AW14Saurabh/cubesat-adcs/Reaction Wheel Platform/RWS v3/PCBs/readme.txt

Readme

PowerV2 - Batteries, VReg + Current sensing PCB (holes spaced to 10xAA battery holder cut in half)
ADCSHubV2 - OBC, Comms, sensors for ADCS
RWSv3a - electronics for Reaction Wheel System
