AW14Saurabh/cubesat-adcs/Reaction Wheel Platform/RWS v3/Code/V2/readme.txt

Don't forget to put everything in the Libraries folder into your arduino libraries folder :)
