AW14Saurabh/cubesat-adcs/Reaction Wheel Platform/RWS v3/PCBs/ADCSHubV2/[BLUESAT FONT].png

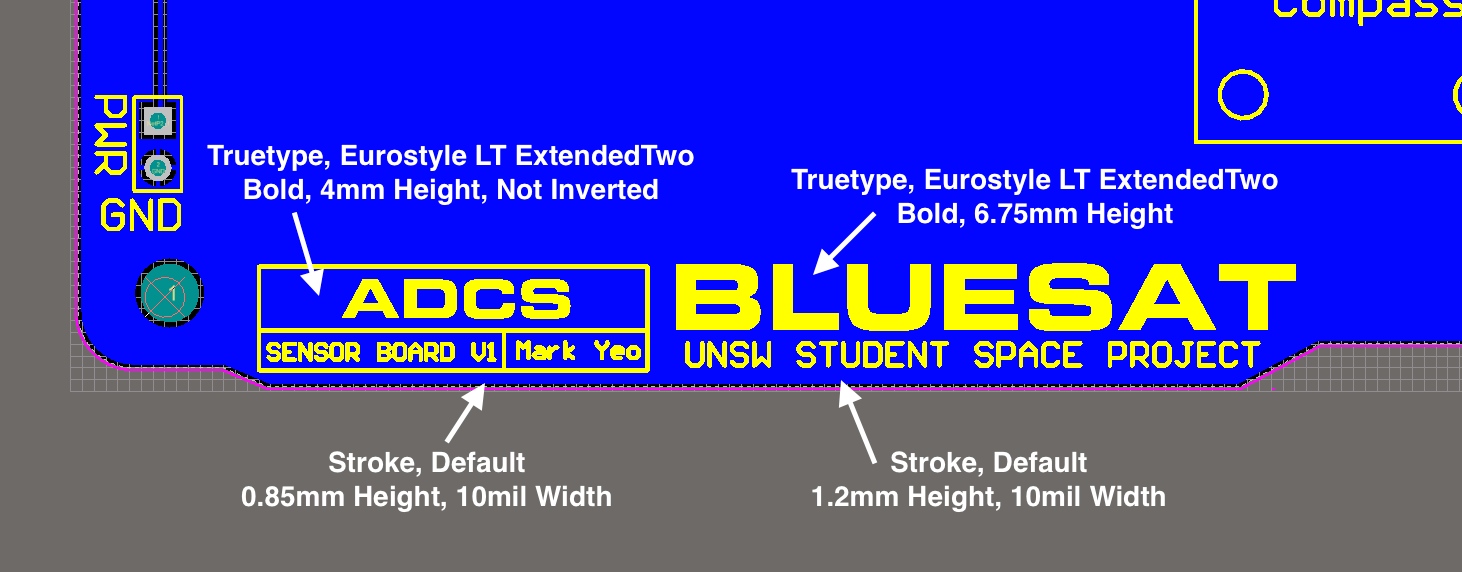
Reaction Wheel Platform/RWS v3/PCBs/ADCSHubV2/[BLUESAT FONT].png
