AW14Saurabh/cubesat-adcs/Reaction Wheel Platform/RWS v3/PCBs/ADCSHubV2/Project Outputs for ADCSHubV2/ADCSHubV2.CSV

Bill of Material for
On 2018-05-08 at 4:01:31 PM
Comment | Pattern | Quantity | Components
10uF | 0805C-GENERIC | 2 | C3, C5 | CAPACITOR 0805 CERAMIC
10uF | 0805C-TBD | 2 | C1, C2 | CAPACITOR 0805 CERAMIC
150R | 0805R-150 | 3 | R4, R5, R6 | RESISTOR 0805 1/4 WATT THIN FILM
200K | 0805R-4K7 | 1 | R11 | RESISTOR 0805 1/4 WATT THIN FILM
26X2 Header | 26X2 Header | 2 | H1, H2
4K7 | 0805R-4K7 | 10 | R1, R2, R3, R7, R8, R9, R10, R12, R13, R14 | RESISTOR 0805 1/4 WATT THIN FILM
Arduino Pro Mini | Arduino Pro Mini | 2 | H4, H5 | Arduino Pro Mini
DPDT Switch | DPDT SWITCH | 1 | SW1 | DPDT Switch
Header 6 | HDR1X6 | 2 | H3, H12 | Header, 6-Pin
HEADER-1X2 | HEADER-1X2 | 2 | H10, H11
HMC5883L | HMC5883L | 1 | H6 | Magnetometer
L3GD20H | L3GD20H | 1 | H7 | Gyroscope
LED | LED | 3 | D1, D2, D3 | Small LED
NRF24L01 | NRF24L01 | 1 | H9 | Radio Transceiver
PCA9306 | PCA9306 (DCT) | 1 | U2 | Dual Bidirectional I2C Voltage Level Translator
PushButton | PushButton | 1 | PB1
uSD Card Module | uSD Card Module | 1 | H8 | uSD Card Module
