AW14Saurabh/cubesat-adcs/Reaction Wheel Platform/RWS v3/Mech Parts/PCB.step

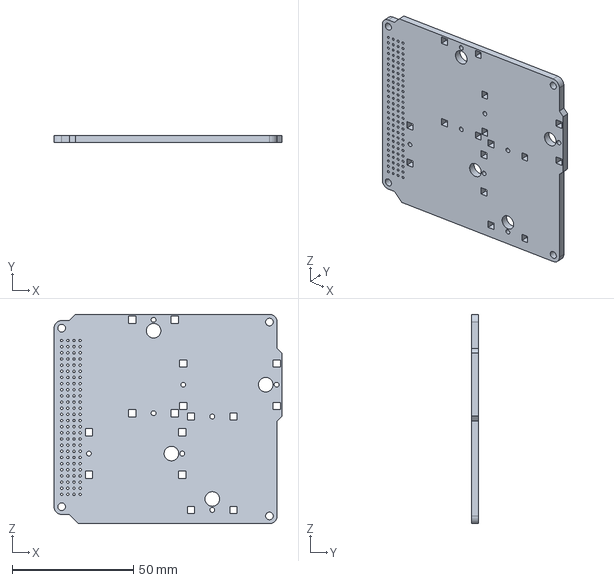
[picture p3: CAD file, 2018-05-28]
Reaction Wheel Platform/RWS v3/Mech Parts/PCB.step
94.1 x 3.00 x 86.4 mm
