AW14Saurabh/cubesat-adcs/Reaction Wheel Platform/RWS v3/Mech Parts/TopPlate.step

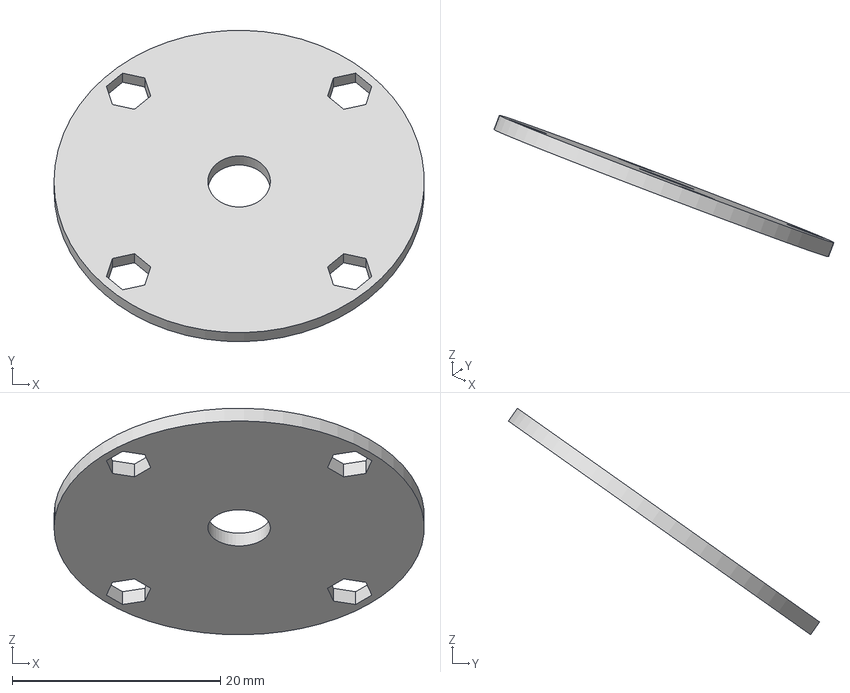
[picture p4: CAD file, 2018-05-28]
Reaction Wheel Platform/RWS v3/Mech Parts/TopPlate.step
35.5 x 29.9 x 21.7 mm
