AW14Saurabh/cubesat-adcs/Reaction Wheel Platform/RWS v3/Mech Parts/SidePlateL.step

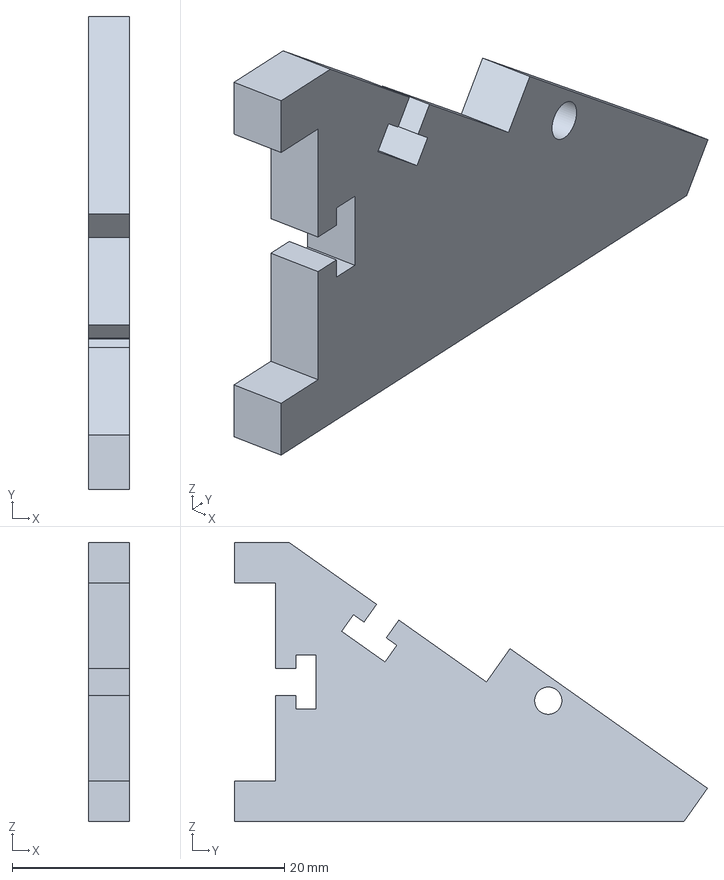
[picture p5: CAD file, 2018-05-28]
Reaction Wheel Platform/RWS v3/Mech Parts/SidePlateL.step
3.00 x 34.7 x 20.5 mm
