AW14Saurabh/cubesat-adcs/Reaction Wheel Platform/RWS v3/Mech Parts/BackPlate.step

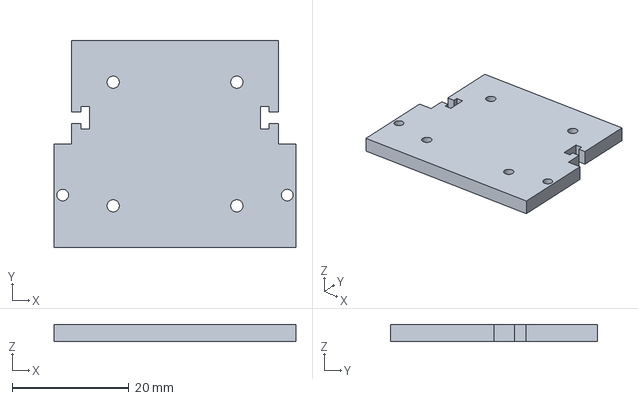
[picture p6: CAD file, 2018-05-28]
Reaction Wheel Platform/RWS v3/Mech Parts/BackPlate.step
41.5 x 35.5 x 3.00 mm
