AW14Saurabh/cubesat-adcs/Reaction Wheel Platform/RWS v3/Data Analysis/Support/Current Calibration.xlsx

Current (A) | Arduino reading
0.62 | 383.9675926 | 369 | 289 | 235 | 233 | 143
0.93 | 302.3868613 | 350 | 299 | 253 | 227 | 173
1.06 | 264.4245283 | 368 | 278 | 268 | 180 | 133
1.26 | 216.5129534 | 419 | 317 | 284 | 212 | 165
1.49 | 150.1578947 | 383 | 327 | 283 | 199 | 145
 |  | 377 | 304 | 267 | 245 | 130
 |  | 380 | 307 | 230 | 206 | 166
 |  | 369 | 312 | 249 | 205 | 133
 | Ard = -267.31*I+550.05 | 401 | 272 | 255 | 192 | 183
I = -Ard/267.31+2.0577 |  | 358 | 315 | 268 | 185 | 158
 |  | 374 | 302 | 306 | 246 | 147
 |  | 371 | 290 | 250 | 214 | 162
 |  | 384 | 309 | 308 | 237 | 150
 |  | 426 | 330 | 283 | 221 | 165
 |  | 388 | 323 | 250 | 242 | 163
 |  | 443 | 282 | 266 | 234 | 143
 |  | 367 | 315 | 252 | 237 | 173
 |  | 388 | 309 | 239 | 204 | 184
 |  | 357 | 275 | 266 | 227 | 136
 |  | 331 | 340 | 299 | 222 | 130
 |  | 388 | 339 | 260 | 205 | 176
 |  | 358 | 316 | 259 | 229 | 139
 |  | 394 | 301 | 281 | 191 | 157
 |  | 402 | 280 | 257 | 207 | 163
 |  | 397 | 312 | 262 | 200 | 158
 |  | 374 | 324 | 259 | 214 | 143
 |  | 389 | 279 | 285 | 236 | 147
 |  | 359 | 288 | 253 | 196 | 131
 |  | 354 | 381 | 313 | 228 | 160
 |  | 416 | 283 | 279 | 226 | 143
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
