AW14Saurabh/cubesat-adcs/Reaction Wheel Platform/RWS v3/Code/V1/RWS/Motor Driver Testing/MotorFreqData/MotorFreqCalib.xlsx

Sheet: FreqChip
T | Freq | Vout |  |  |  |  |  | Vout Ave |  | Datasheet values
1 | 1000 | 738 | 738 | 742 | 742 | 747 | 747 | 742.3333333 |  | 760 | 5 | 100000 | 1e-08 | 3.8 | 777.48
1 | 1000 | 368 | 367 | 371 | 369 | 374 | 372 | 370.1666667 |  | 700 | 5 | 100000 | 1e-08 | 3.5 | 716.1
2 | 500 | 188 | 187 | 189 | 188 | 191 | 190 | 188.8333333 |  | 650 | 5 | 100000 | 1e-08 | 3.25 | 664.95
3 | 333.3333333 | 125 | 124 | 125 | 125 | 126 | 126 | 125.1666667 |  | 600 | 5 | 100000 | 1e-08 | 3 | 613.8
4 | 250 | 93 | 93 | 93 | 93 | 94 | 94 | 93.33333333 |  | 550 | 5 | 100000 | 1e-08 | 2.75 | 562.65
5 | 200 | 76 | 76 | 76 | 76 | 77 | 77 | 76.33333333 |  | 500 | 5 | 100000 | 1e-08 | 2.5 | 511.5
7 | 142.8571429 | 63 | 63 | 63 | 63 | 63 | 63 | 63 |  | 450 | 5 | 100000 | 1e-08 | 2.25 | 460.35
7 | 142.8571429 | 52 | 52 | 52 | 52 | 52 | 52 | 52 |  | 400 | 5 | 100000 | 1e-08 | 2 | 409.2
508 | 1968.503937 | 749 | 749 |  |  |  |  | 749
780 | 1282.051282 | 496 | 493 |  |  |  |  | 493
1004 | 996.0159363 | 377 | 375 |  |  |  |  | 375
1280 | 781.25 | 300 | 298 |  |  |  |  | 298
1504 | 664.893617 | 254 | 253 |  |  |  |  | 253
1788 | 559.2841163 | 219 | 217 |  |  |  |  | 217
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
