AW14Saurabh/cubesat-adcs/Reaction Wheel Platform/RWS v3/Code/V1/RWS/Motor Driver Testing/MotorFreqData/expected vout from freq.xlsx

 | Freq | VCC | R1 | C1 | Vout
Max | 760 | 5 | 100000 | 1e-08 | 3.8
Min reliable | 60 | 5 | 100000 | 1e-08 | 0.3
 |  | VOUT = fIN × VCC × R1 × C1
