AW14Saurabh/cubesat-adcs/Reaction Wheel Platform/RWS v3/Mech Parts/Engineering Drawings/MountingPlate.pdf

# 2.54 ².54

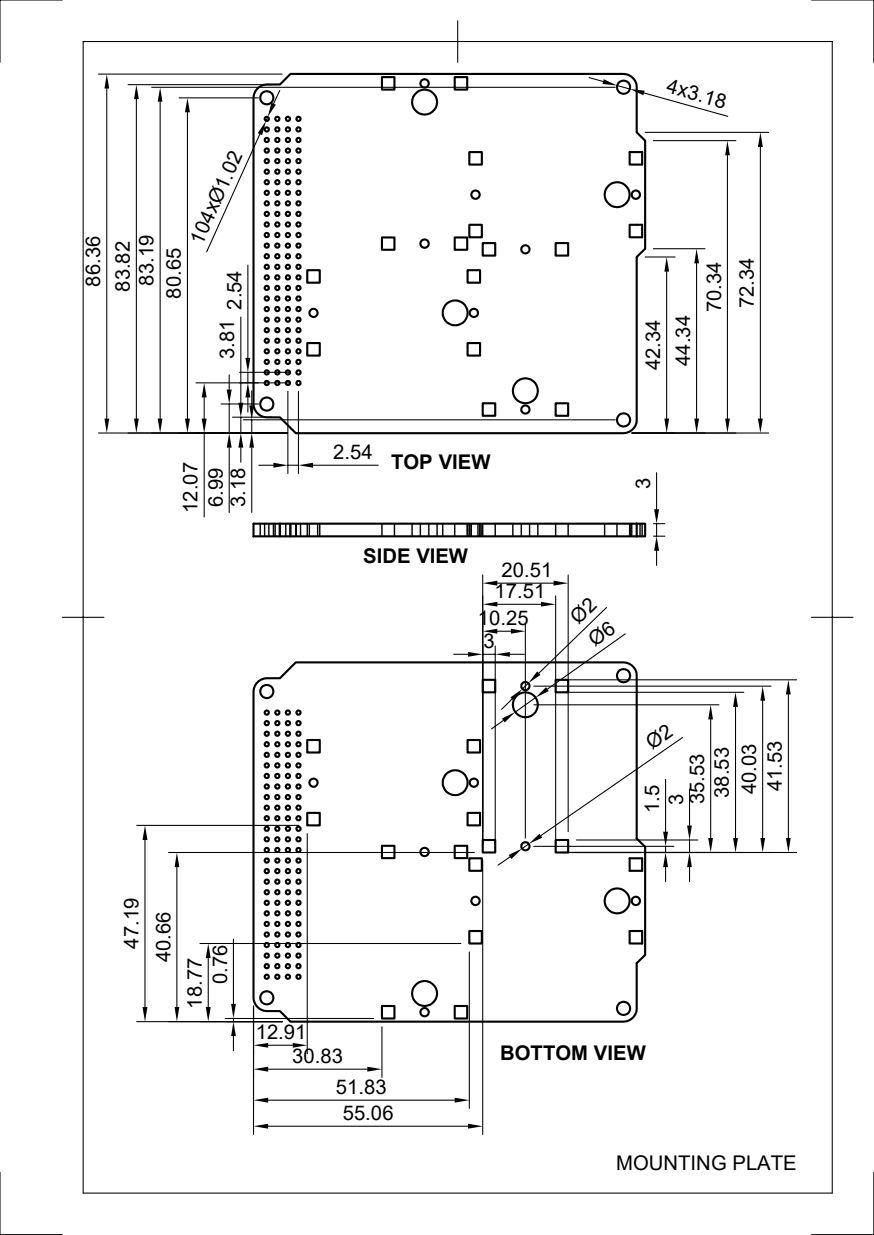
[picture p8: page 1]
TOP VIEW; SIDE VIEW; BOTTOM VIEW; MOUNTING PLATE
