AW14Saurabh/cubesat-adcs/Reaction Wheel Platform/RWS v3/Mech Parts/Engineering Drawings/Wheel.pdf

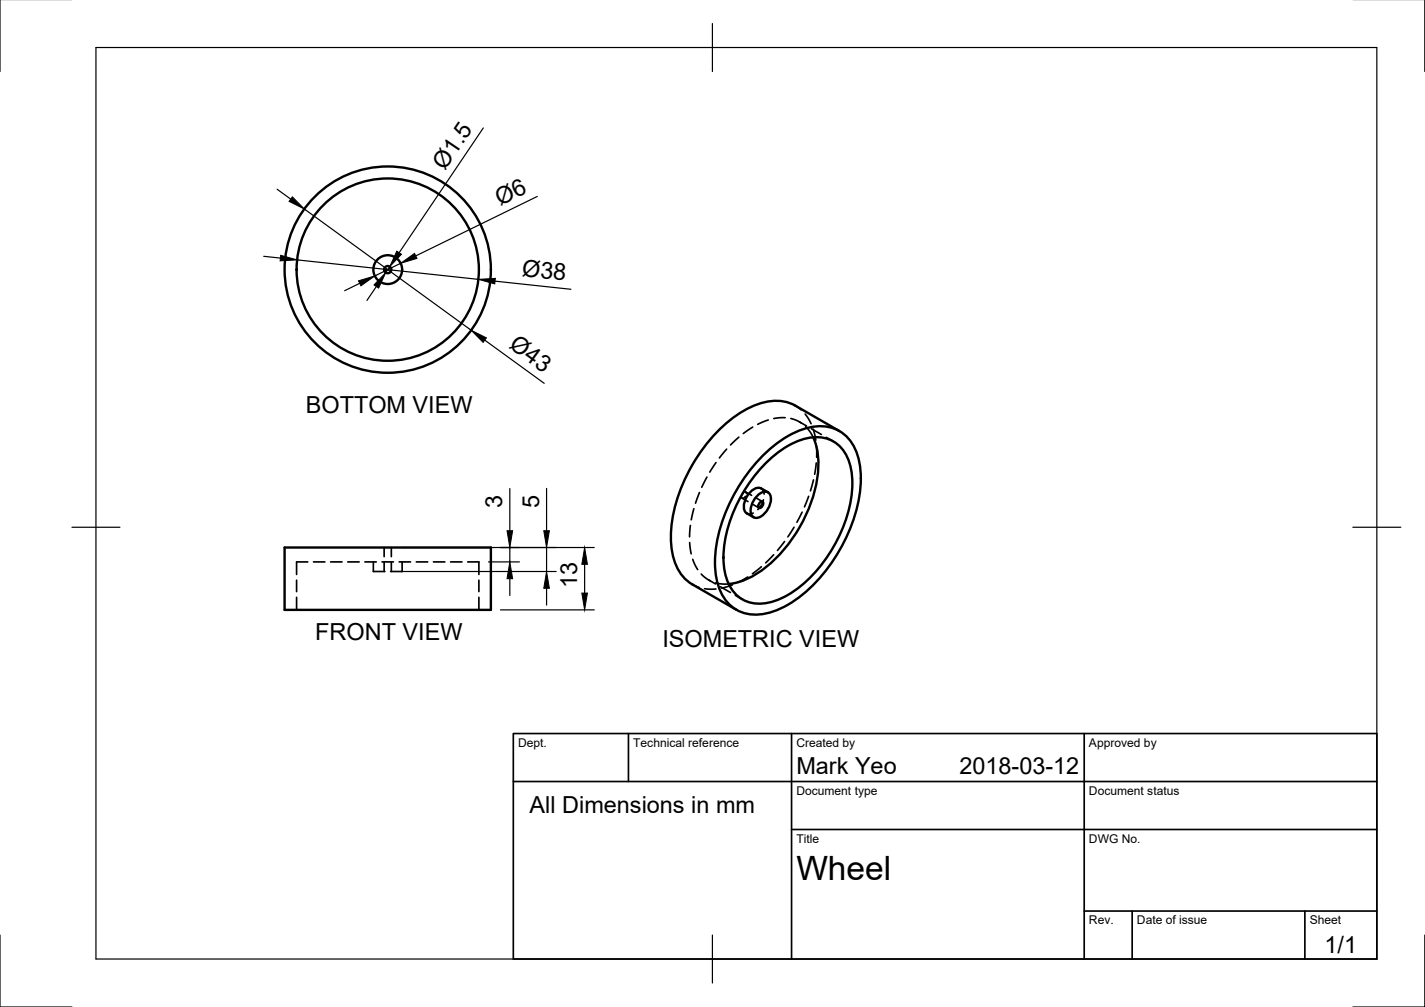
[picture p9: page 1]
BOTTOM VIEW; FRONT VIEW; ISOMETRIC VIEW

Dept. | Technical reference | Created by Mark Yeo 2018-03-12 | Approved by

All Dimensions in mm | | Document type | Document status

Title Wheel | DWG No.

Rev. | Date of issue | Sheet 1/1
