AW14Saurabh/cubesat-adcs/Reaction Wheel Platform/RWS v3/Mech Parts/Engineering Drawings/CutRing.pdf

# TOP VIEW

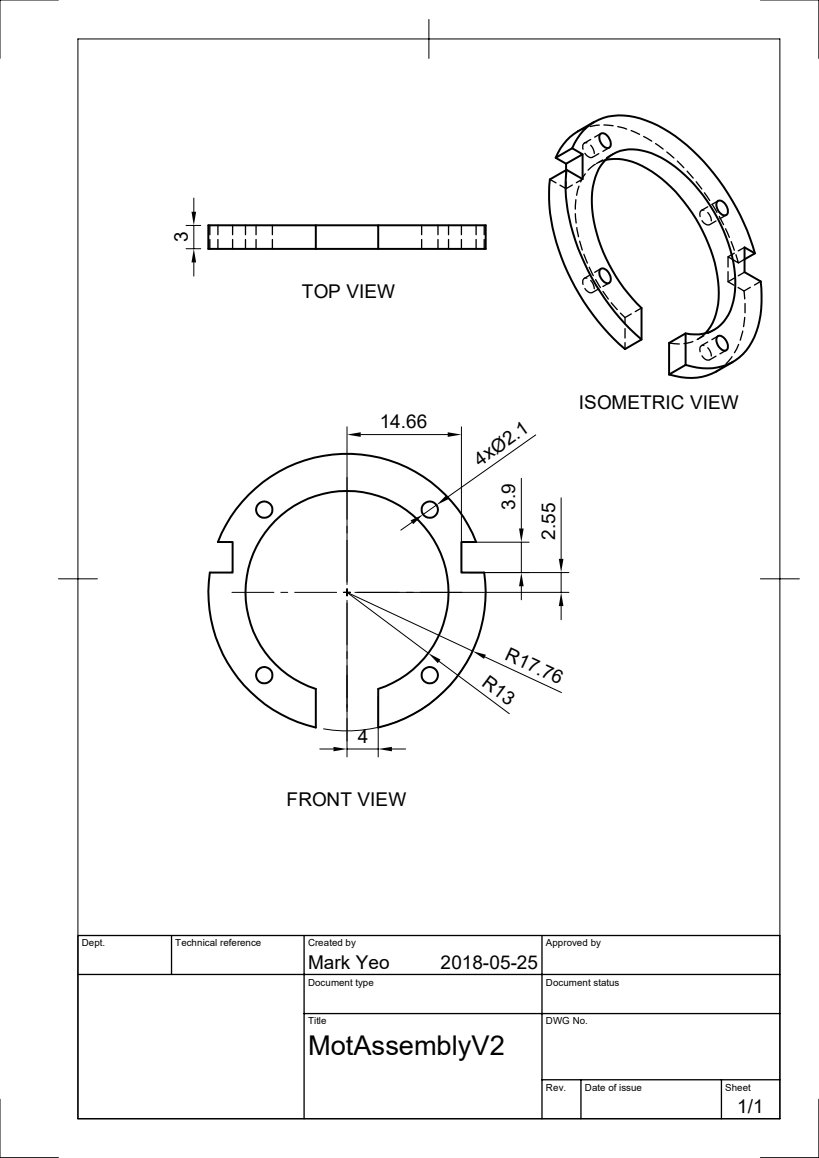
[picture p11: page 1]
Dept.; Technical reference; Created by; Approved by; Mark Yeo; FRONT VIEW; ISOMETRIC VIEW

Document type | Document status

Title MotAssemblyV2 | DWG No.

Rev. | Date of issue | Sheet 1/1
