AW14Saurabh/cubesat-adcs/Reaction Wheel Platform/RWS v3/Mech Parts/Engineering Drawings/TopPlate.pdf

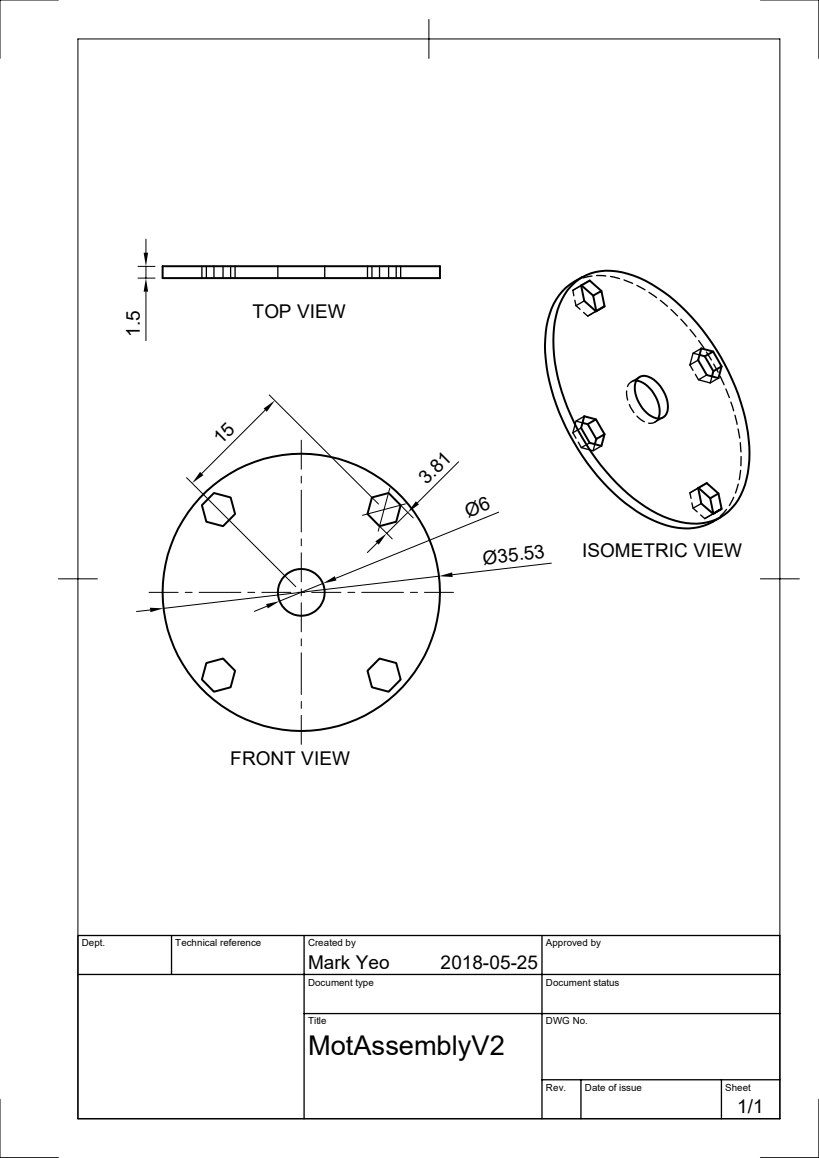
[picture p12: page 1]
Dept.; Technical reference; Created by; Approved by; Mark Yeo; TOP VIEW; ISOMETRIC VIEW; FRONT VIEW ¹.5

Document type | Document status

Title MotAssemblyV2 | DWG No.

Rev. | Date of issue | Sheet 1/1
