AW14Saurabh/cubesat-adcs/Reaction Wheel Platform/RWS v3/PCBs/PDFs/ADCS.pdf

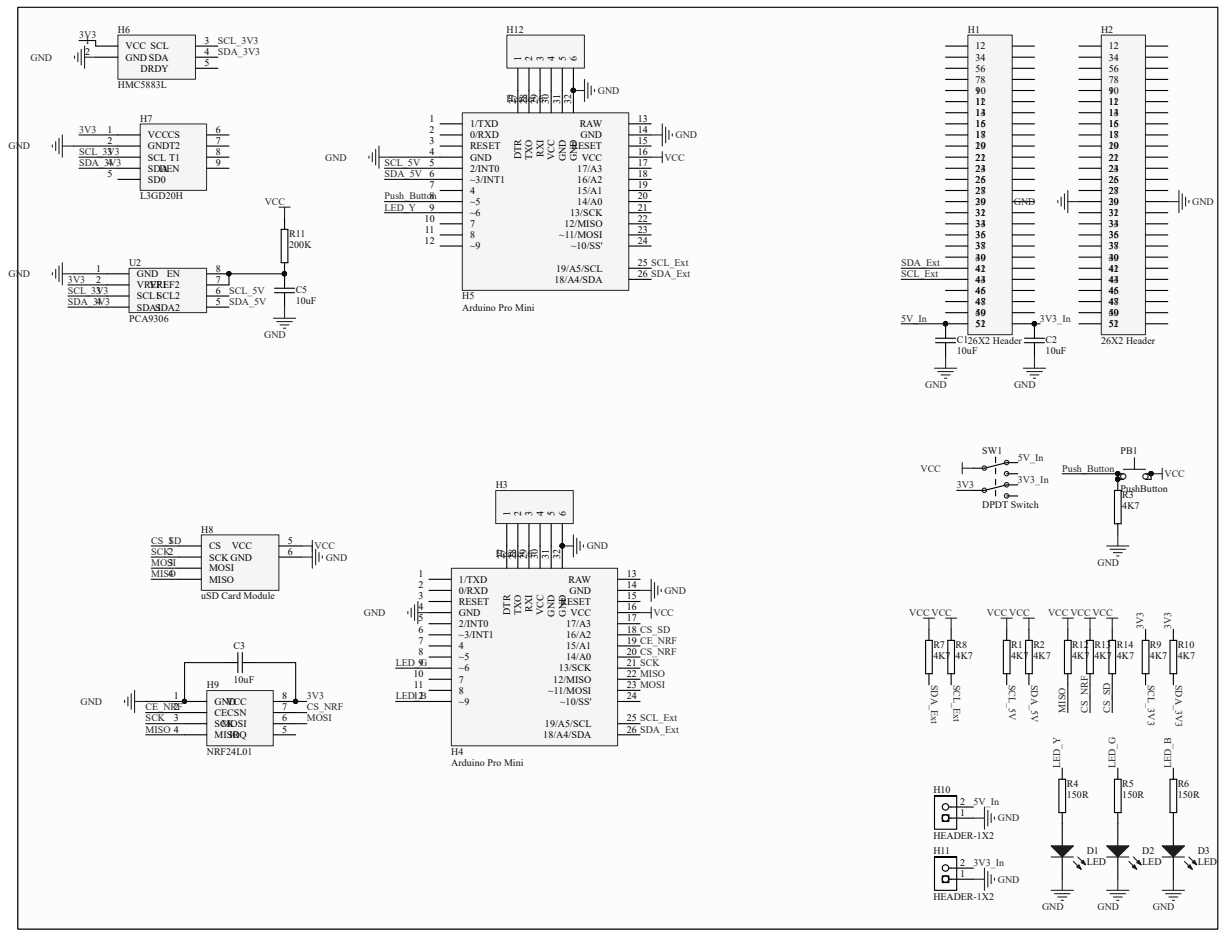
[picture p13: page 1]
