AW14Saurabh/cubesat-adcs/Reaction Wheel Platform/RWS v3/PCBs/PDFs/Power.pdf

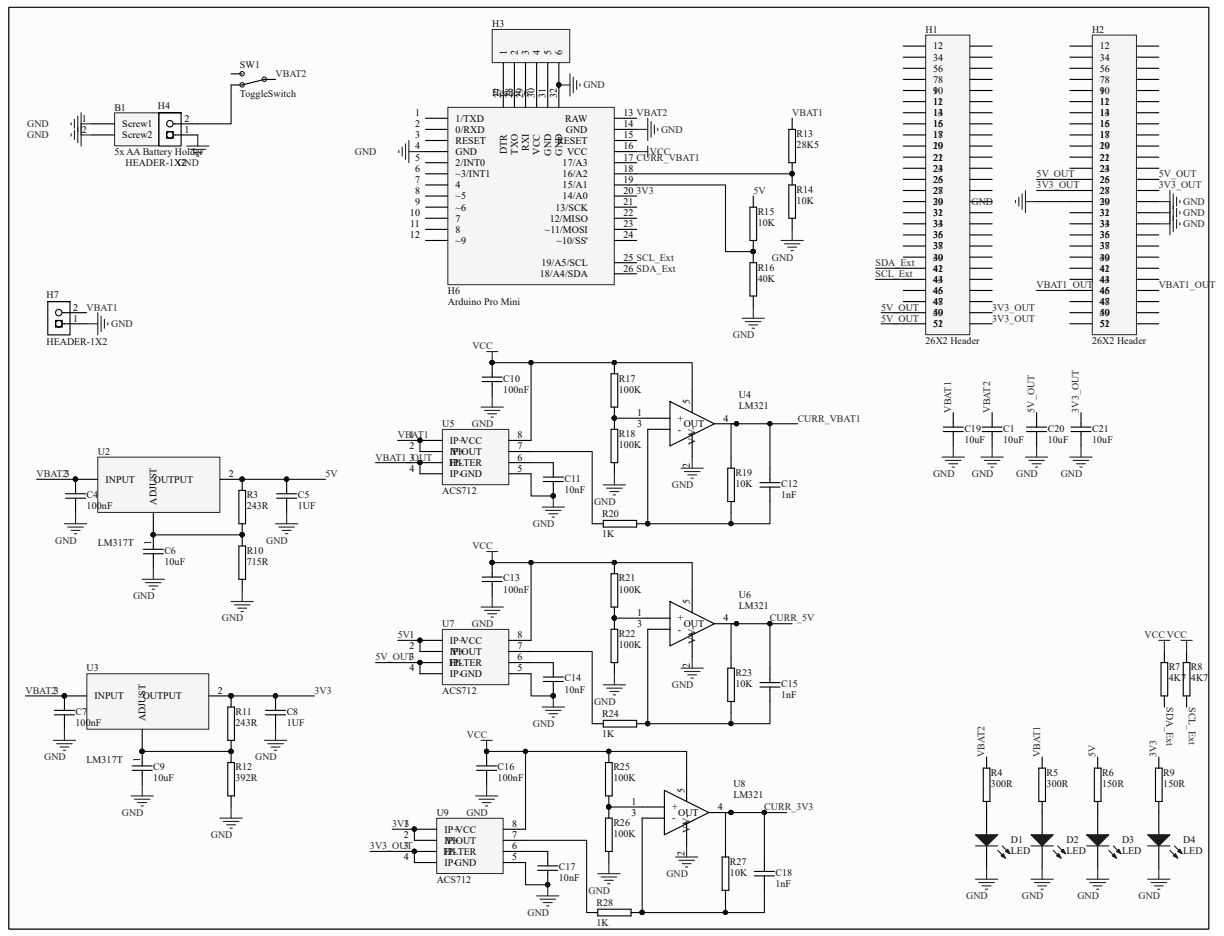
[picture p14: page 1]
