AW14Saurabh/cubesat-adcs/Reaction Wheel Platform/RWS v3/PCBs/PDFs/RWSMain.pdf

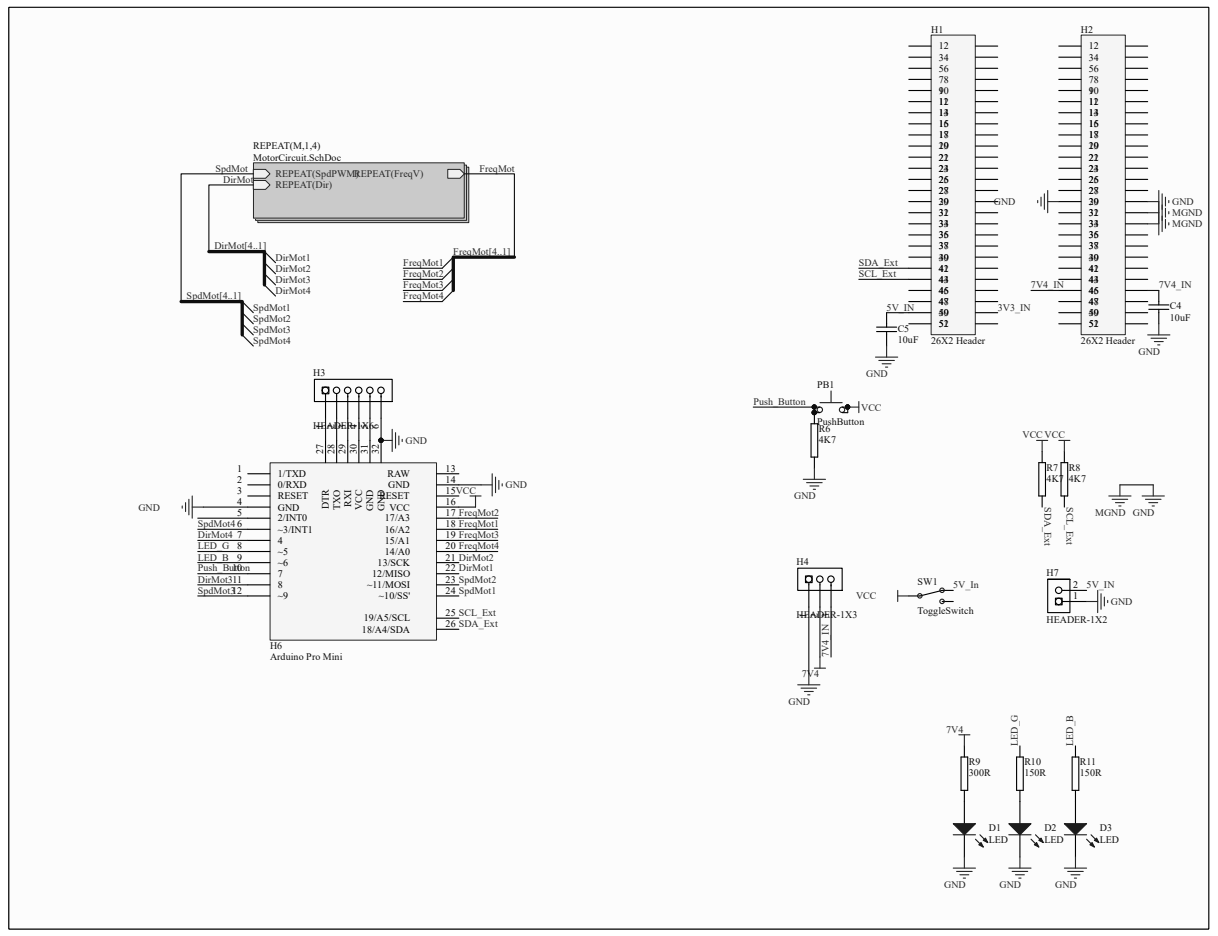
[picture p15: page 1]
