AW14Saurabh/cubesat-adcs/Reaction Wheel Platform/RWS v3/PCBs/PDFs/RWSMotorCircuit.pdf

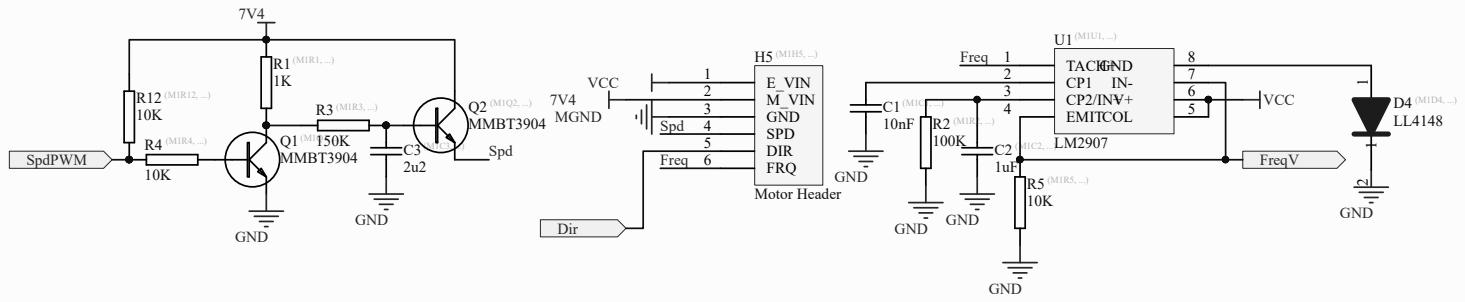
[picture p16: page 1]
