AW14Saurabh/cubesat-adcs/(list of files, drawings)

Other design files:
Reaction Wheel Platform/CtrlBox v2/PCB/Components.PcbLib
Reaction Wheel Platform/CtrlBox v2/PCB/Components.SchLib
Reaction Wheel Platform/CtrlBox v2/PCB/CtrlBoxV2.PcbDoc
Reaction Wheel Platform/CtrlBox v2/PCB/CtrlBoxV2.PrjPcb
Reaction Wheel Platform/CtrlBox v2/PCB/CtrlBoxV2.SchDoc
Reaction Wheel Platform/RWS v3/PCBs/ADCSHub/ADCSHub.PcbDoc
Reaction Wheel Platform/RWS v3/PCBs/ADCSHub/ADCSHub.PrjPcb
Reaction Wheel Platform/RWS v3/PCBs/ADCSHub/ADCSHub.SchDoc
Reaction Wheel Platform/RWS v3/PCBs/ADCSHub/Components.PcbLib
Reaction Wheel Platform/RWS v3/PCBs/ADCSHub/Components.SchLib
Reaction Wheel Platform/RWS v3/PCBs/ADCSHub/CubeSatHeaders.PcbLib
Reaction Wheel Platform/RWS v3/PCBs/ADCSHub/SBv1Components.PcbLib
Reaction Wheel Platform/RWS v3/PCBs/ADCSHubV2/ADCSHubV2.PcbDoc
Reaction Wheel Platform/RWS v3/PCBs/ADCSHubV2/ADCSHubV2.PrjPcb
Reaction Wheel Platform/RWS v3/PCBs/ADCSHubV2/ADCSHubV2.SchDoc
Reaction Wheel Platform/RWS v3/PCBs/OBCComms/Components.PcbLib
Reaction Wheel Platform/RWS v3/PCBs/OBCComms/Components.SchLib
Reaction Wheel Platform/RWS v3/PCBs/OBCComms/OBCComms.PcbDoc
Reaction Wheel Platform/RWS v3/PCBs/OBCComms/OBCComms.PrjPcb
Reaction Wheel Platform/RWS v3/PCBs/OBCComms/OBCComms.SchDoc
Reaction Wheel Platform/RWS v3/PCBs/Power/Components.PcbLib
Reaction Wheel Platform/RWS v3/PCBs/Power/Components.SchLib
Reaction Wheel Platform/RWS v3/PCBs/Power/Power.SchDoc
Reaction Wheel Platform/RWS v3/PCBs/PowerV2/PowerV2.PcbDoc
Reaction Wheel Platform/RWS v3/PCBs/PowerV2/PowerV2.PrjPcb
Reaction Wheel Platform/RWS v3/PCBs/PowerV2/PowerV2.SchDoc
Reaction Wheel Platform/RWS v3/PCBs/RWSv3/Acrylic Layer/RWSv3_TOP_LAYER.PcbDoc
Reaction Wheel Platform/RWS v3/PCBs/RWSv3/MotorCircuit.SchDoc
Reaction Wheel Platform/RWS v3/PCBs/RWSv3/RWSComponents.PcbLib
Reaction Wheel Platform/RWS v3/PCBs/RWSv3/RWSComponents.SchLib
Reaction Wheel Platform/RWS v3/PCBs/RWSv3/RWSv3.PcbDoc
Reaction Wheel Platform/RWS v3/PCBs/RWSv3/RWSv3.PrjPcb
Reaction Wheel Platform/RWS v3/PCBs/RWSv3/RWSv3.SchDoc
Reaction Wheel Platform/RWS v3/PCBs/RWSv3a/MotorCircuit.SchDoc
Reaction Wheel Platform/RWS v3/PCBs/RWSv3a/RWSv3a.PcbDoc
Reaction Wheel Platform/RWS v3/PCBs/RWSv3a/RWSv3a.PrjPcb
Reaction Wheel Platform/RWS v3/PCBs/RWSv3a/RWSv3a.SchDoc
Reaction Wheel Platform/RWS v3/PCBs/SupportComponents/CubeSatHeaders.PcbLib
Reaction Wheel Platform/RWS v3/PCBs/SupportComponents/CubeSatHeaders.SchLib
Reaction Wheel Platform/RWS v3/PCBs/SupportComponents/RWSComponents.PcbLib
Reaction Wheel Platform/RWS v3/PCBs/SupportComponents/RWSComponents.SchLib
Reaction Wheel Platform/RWS v3/PCBs/SupportComponents/SBv1Components.PcbLib
Reaction Wheel Platform/RWS v3/PCBs/SupportComponents/SBv1Components.SchLib
Reaction Wheel Platform/RWS v3/PCBs/SupportComponents/SupportComponents.PcbLib
Reaction Wheel Platform/RWS v3/PCBs/SupportComponents/SupportComponents.SchLib
Sensor Board/PCB Files v1/v1/sensor_board_v1_ordered/BLUESatPC104Template.PcbDoc
Sensor Board/PCB Files v1/v1/sensor_board_v1_ordered/BLUESatPC104Template.SchDoc
Sensor Board/PCB Files v1/v1/sensor_board_v1_ordered/CustomParts.PcbLib
Sensor Board/PCB Files v1/v1/sensor_board_v1_ordered/CustomParts.SchLib
Sensor Board/PCB Files v1/v1/sensor_board_v1_ordered/Pcb Footprints.PcbLib
Sensor Board/PCB Files v1/v1/sensor_board_v1_ordered/Schlib1.SchLib
Sensor Board/PCB Files v1/v1/sensor_board_v1_ordered/sensor_board_v1.PrjPcb
Sensor Board/PCB Files v2/CubeSatBoardTemplatev2/CubeSatBoardTemplate.PrjPcb
Sensor Board/PCB Files v2/CubeSatBoardTemplatev2/CubeSatBoardTemplate.SchDoc
Sensor Board/PCB Files v2/CubeSatBoardTemplatev2/CubeSatBoardTemplatev2.0.PcbDoc
Sensor Board/PCB Files v2/CubeSatBoardTemplatev2/CubeSatBoardTemplatev2.1.PcbDoc
Sensor Board/PCB Files v2/CubeSatBoardTemplatev2/CubeSatBoardTemplatev2.2.PcbDoc
Sensor Board/PCB Files v2/CubeSatBoardTemplatev2/CubeSatBoardTemplatev2.2[forstepexporting].PcbDoc
Sensor Board/PCB Files v2/CubeSatBoardTemplatev2/CubeSatHeader.PcbLib
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
