AW14Saurabh/cubesat-adcs/(commit log)

2016-11-01 Moved old files to 'Magnetorquer Platform' folder
2016-11-01 Uploaded new ADCS files to 'Reaction Wheel Platform' folder
2016-11-09 Added code for hall-effect sensor reading
2017-02-13 Got rid of old code (didn’t work) Added new code (works) Edited readme file w/ code descriptions
2017-02-15 Polished up pointing code Made code for o-week (switch between detumble + pointing w/o having to reupload code to arduino) Moved rws v1 code into folders Added test code for rws v2 (something wrong w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
2017-05-06 added Grace’s gyro + PID controller code
2017-05-06 Updated rws v1 code to accept new struct rf messages, also added sensor libraries
2017-05-13 Modified + added Grace’s 9-axis address changing code
2017-06-03 Uploaded PCB files for sensor board
    [BLUESatPC104Template.PcbDoc, BLUESatPC104Template.SchDoc, CustomParts.PcbLib, CustomParts.SchLib, Pcb Footprints.PcbLib, Schlib1.SchLib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]
2017-07-09 Added PCB code
2017-07-21 Added sensor board code (complete)
2017-07-21 Uploaded Chris’ RWSv2 code + moved some libraries around
2017-08-03 added 5min power board reset timer + millis logging
    [DataLoggerV1.ino]
2017-08-03 changed 5min reset timer implementation millis to datetime
    [DataLoggerV1.ino]
2017-09-11 Finished program minus PID constant tuning
2017-09-28 Finished sensor board time logger, uploaded SB debug log
2017-09-28 Added to Sensor board debug log Added CubeSat Board Template v2
    [CubeSatBoardTemplate.PcbDoc, CubeSatBoardTemplate.PrjPcb, CubeSatBoardTemplate.SchDoc, CubeSatHeader.PcbLib, CubeSatHeader.SchLib]
2017-10-01 Sensor Board: Wrote RTCTimeSet to set RTC, removed delay from DataLoggerV1 + timeLogger
2017-12-12 Updated CubeSatBoardTemplatev2 - added BSat logo + trimmed board edges in to mounting hole pad edges Started SensorBoardv2 project + made schematic library components
    [BLUESatPC104Template.PcbDoc, BLUESatPC104Template.SchDoc, Components.SchLib, CubeSatBoardTemplate.PcbDoc, CubeSatBoardTemplate.PrjPcb, CubeSatBoardTemplate.SchDoc, CubeSatBoardTemplatev2.0.PcbDoc, CubeSatBoardTemplatev2.1.PcbDoc]
2017-12-24 Uploaded Sensor Board v2 PCB files (finished, final check not done)
    [Components.PcbLib, Components.SchLib, CubeSatBoardTemplatev2.1.PcbDoc, CubeSatHeader.PcbLib, CubeSatHeaders.PcbLib, SBv1Components.PcbLib, SBv1Components.SchLib, SensorBoardv2.PcbDoc]
2017-12-26 Designed + uploaded OBC+Comms board. Minor change to toggle switch footprint
    [Components.PcbLib, Components.SchLib, CubeSatHeaders.PcbLib, CubeSatHeaders.SchLib, OBCComms.PcbDoc, OBCComms.PrjPcb, OBCComms.SchDoc, SBv1Components.PcbLib]
2017-12-26 just moved files around
    [Components.PcbLib, Components.SchLib, CubeSatHeaders.PcbLib, CubeSatHeaders.SchLib, OBCComms.PcbDoc, OBCComms.PrjPcb, OBCComms.SchDoc, SBv1Components.PcbLib]
2017-12-30 Designed GNDstation + Power boards, added 3v3 regulator to OBC
    [Components.PcbLib, Components.SchLib, CtrlBoxV2.PcbDoc, CtrlBoxV2.PrjPcb, CtrlBoxV2.SchDoc, CubeSatHeaders.PcbLib, CubeSatHeaders.SchLib, OBCComms.PcbDoc]
2018-01-01 Designed ADCS Hub, made minor modifications to other boards
    [ADCSHub.PcbDoc, ADCSHub.PrjPcb, ADCSHub.SchDoc, Components.PcbLib, Components.SchLib, CtrlBoxV2.PcbDoc, CtrlBoxV2.SchDoc, CubeSatHeaders.PcbLib]
2018-01-01 Fixed up + added silkscreen text, minor component shifts to accommodate text
    [ADCSHub.PcbDoc, ADCSHub.SchDoc, CtrlBoxV2.PcbDoc, CtrlBoxV2.SchDoc, OBCComms.PcbDoc, Power.PcbDoc, SensorBoardv2.PcbDoc]
2018-03-07 Added 3v3 vregs + i2c voltage converters for bno's
2018-03-25 Made changes to ADCSHub, CtrlBox, OBCComms + Power: - used 3v3 in from header instead of on-board regulator - gave 3v3 to sensor boards that needed it - added power isolating header for bno055 (break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
    [ADCSHub.PcbDoc, ADCSHub.SchDoc, Components.PcbLib, CtrlBoxV2.PcbDoc, CtrlBoxV2.SchDoc, OBCComms.PcbDoc, OBCComms.SchDoc, Power.PcbDoc]
2018-03-26 Made 3v3 + BNO055 changes to sensor board
    [SensorBoardv2.PcbDoc, SensorBoardv2.SchDoc]
2018-03-31 Checked support boards (minor changes)
    [ADCSHub.PcbDoc, ADCSHub.SchDoc, CtrlBoxV2.PcbDoc, OBCComms.PcbDoc, Power.PcbDoc, SensorBoardv2.PcbDoc, SensorBoardv2.SchDoc]
2018-04-02 Most of way through schematic + got rooms working w/ routing for RWS
    [CubeSatBoardTemplate.PrjPcb, CubeSatBoardTemplate.SchDoc, CubeSatBoardTemplatev2.2.PcbDoc, CubeSatHeaders.PcbLib, CubeSatHeaders.SchLib, MotorCircuit.SchDoc, RWSComponents.PcbLib, RWSComponents.SchLib]
2018-04-05 Finished designing RWS pcb - adjusted pwm->7v4 analog converter circuit after doing some breadboard experiments - routed board
    [ADCSHub.PcbDoc, MotorCircuit.SchDoc, OBCComms.PcbDoc, Power.PcbDoc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]
2018-04-05 Exported to Gerbers (for PCBWay)
    [ADCSHub.GBL, ADCSHub.GBO, ADCSHub.GBP, ADCSHub.GBS, ADCSHub.GKO, ADCSHub.GM1, ADCSHub.GTL, ADCSHub.GTO]
2018-04-12 Saved prjpcb's (forgot to save last time) Changed decoupling caps to 10uF
    [ADCSHub.CSV, ADCSHub.PrjPcb, ADCSHub.SchDoc, CtrlBoxV2.CSV, CtrlBoxV2.PrjPcb, OBCComms.CSV, OBCComms.PrjPcb, OBCComms.SchDoc]
2018-04-16 added detumble (z-axis + 3-axis) + point controllers (z-axis only)
2018-04-22 Wrote code for ctrl box (all minus RF out) + sensor board (all minus extI2C)
    [Wheel I's.xlsx]
2018-04-26 Wrote code for ctrl box tx & obc+comms rx
    [OBCComms.SchDoc]
2018-05-06 Added extra arduino + RF module to ADCS Hub (now 'ADCS + Comms') Laid out software for gyro measurement via SoftI2C relaying data to I2C master on native Wire bus
    [ADCSHub.PrjPcb, ADCSHubV2.PcbDoc, ADCSHubV2.PrjPcb, ADCSHubV2.SchDoc, MotorFreqCalib.xlsx, Power.SchDoc, PowerV2.PcbDoc, PowerV2.PrjPcb]
2018-05-07 Made iteration to pwr board
    [PowerV2.PcbDoc, PowerV2.PrjPcb, PowerV2.SchDoc, SupportComponents.SchLib]
2018-05-07 Iterated rws board, generated gerbers for 3x v2 boards
    [ADCSHubV2.GBL, ADCSHubV2.GBO, ADCSHubV2.GBP, ADCSHubV2.GBS, ADCSHubV2.GKO, ADCSHubV2.GM1, ADCSHubV2.GTL, ADCSHubV2.GTO]
2018-05-18 Wrote code for AttitudeSlave, CommsSlave + PwrMaster
    [ADCSHubV2.CSV, ADCSHubV2.PrjPcb, MotorFreqCalib.xlsx, PowerV2.CSV, PowerV2.PrjPcb, RWSv3a.CSV, RWSv3a.PrjPcb, expected vout from freq.xlsx]
2018-05-21 Got I2C bus working across all boards
2018-05-22 Detumble working for air bearing
    [MotorFreqCalib.xlsx]
2018-05-22 implemented pointing on air bearing
2018-05-23 detumble + point for string test
    [0Control.xlsx, 1DetumbleZ+CCW.xlsx, 1DetumbleZ+CW.xlsx, 2PointZ.xlsx, Current Calibration.xlsx, MotorCalibration.xlsx, serialconfig.txt]
2018-05-28 Uploaded test data + mech parts (as STEPs)
    [BackPlate.step, CurrCalib.xlsx, PCB.step, Ring1.step, Ring3.step, SidePlateL.step, TopPlate.step, airPoint.xlsx]
2018-09-22 Fixed RWSv3 v1 libraries, tweaked sensor board code
    [serialconfig.txt]
